PUT-Motorsport/PUTM_EV_IMD_SAFETY_2024/README.md

# Insulation Monitoring Device driver

A driver for Bender ISOMETER IR155-3203 to comply with FSG Rules 25' about latching, and only hard-wired electronics.
As per September 2025 in PMX Malta it relies only on Bender "IMD OK" signal, no PWM reading part needed
