PUT-Motorsport/PUTM_EV_IMD_SAFETY_2024/documentation/Bender_Dimensions.png

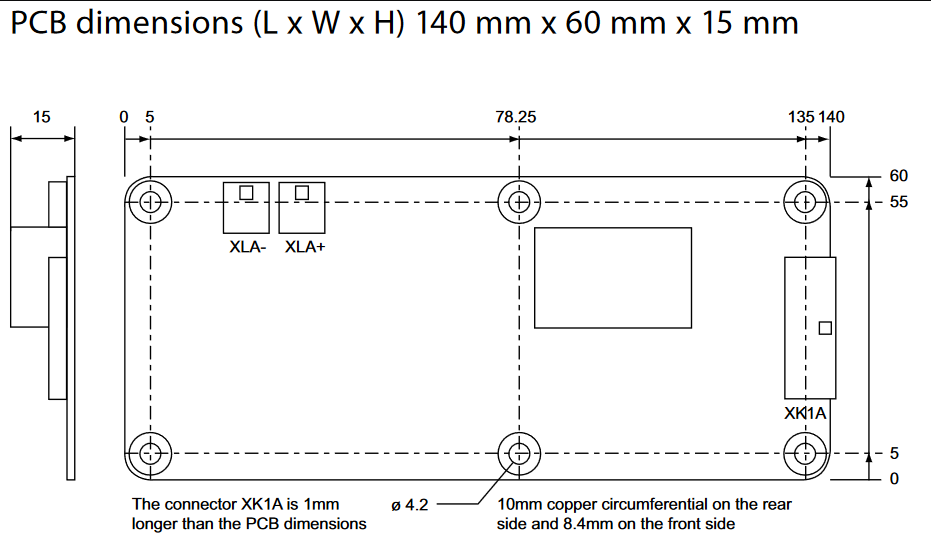
documentation/Bender_Dimensions.png
