PUT-Motorsport/PUTM_EV_IMD_SAFETY_2024/documentation/ESF22_review.png

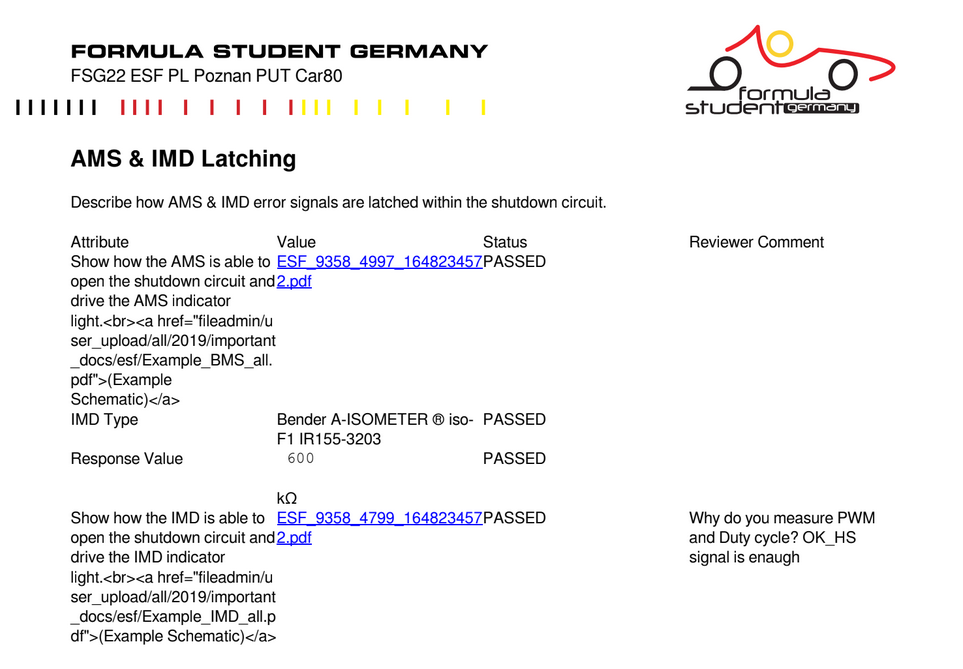
documentation/ESF22_review.png
