PUT-Motorsport/PUTM_EV_IMD_SAFETY_2024/documentation/ESF_Dash_LED_Example.png

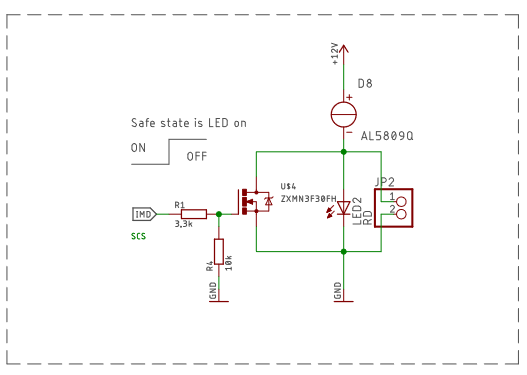
documentation/ESF_Dash_LED_Example.png
