PUT-Motorsport/PUTM_EV_IMD_SAFETY_2024/documentation/ESF_Example_Autoreset.png

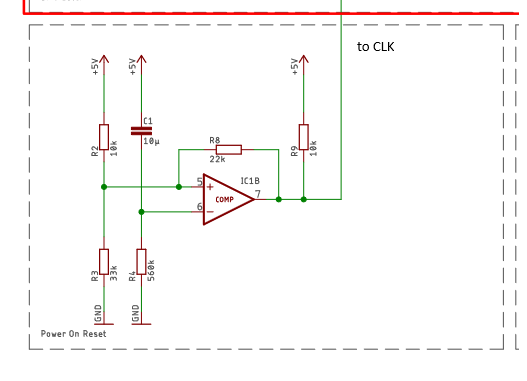
documentation/ESF_Example_Autoreset.png
