PUT-Motorsport/PUTM_EV_IMD_SAFETY_2024/documentation/ESF_Latch_Example.png

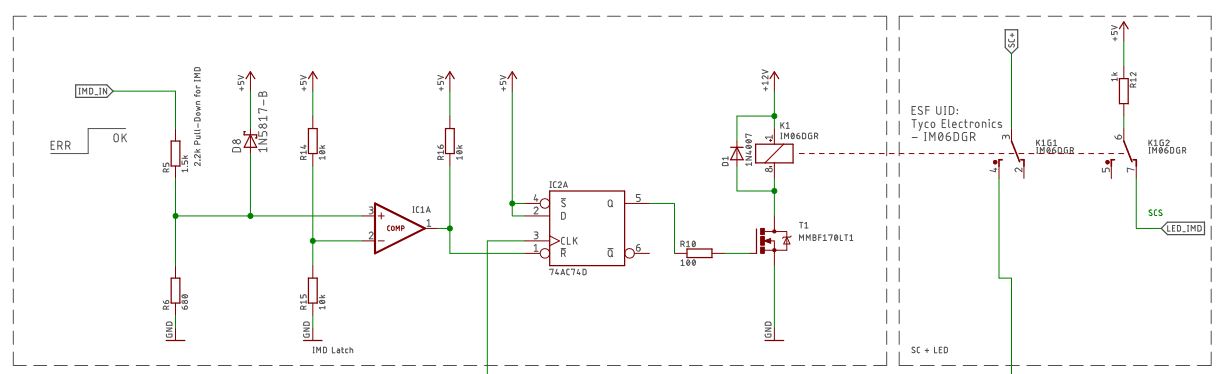
documentation/ESF_Latch_Example.png
