PUT-Motorsport/PUTM_EV_IMD_SAFETY_2024/documentation/ESF_Doc_SDC-IMD_Latch.pdf

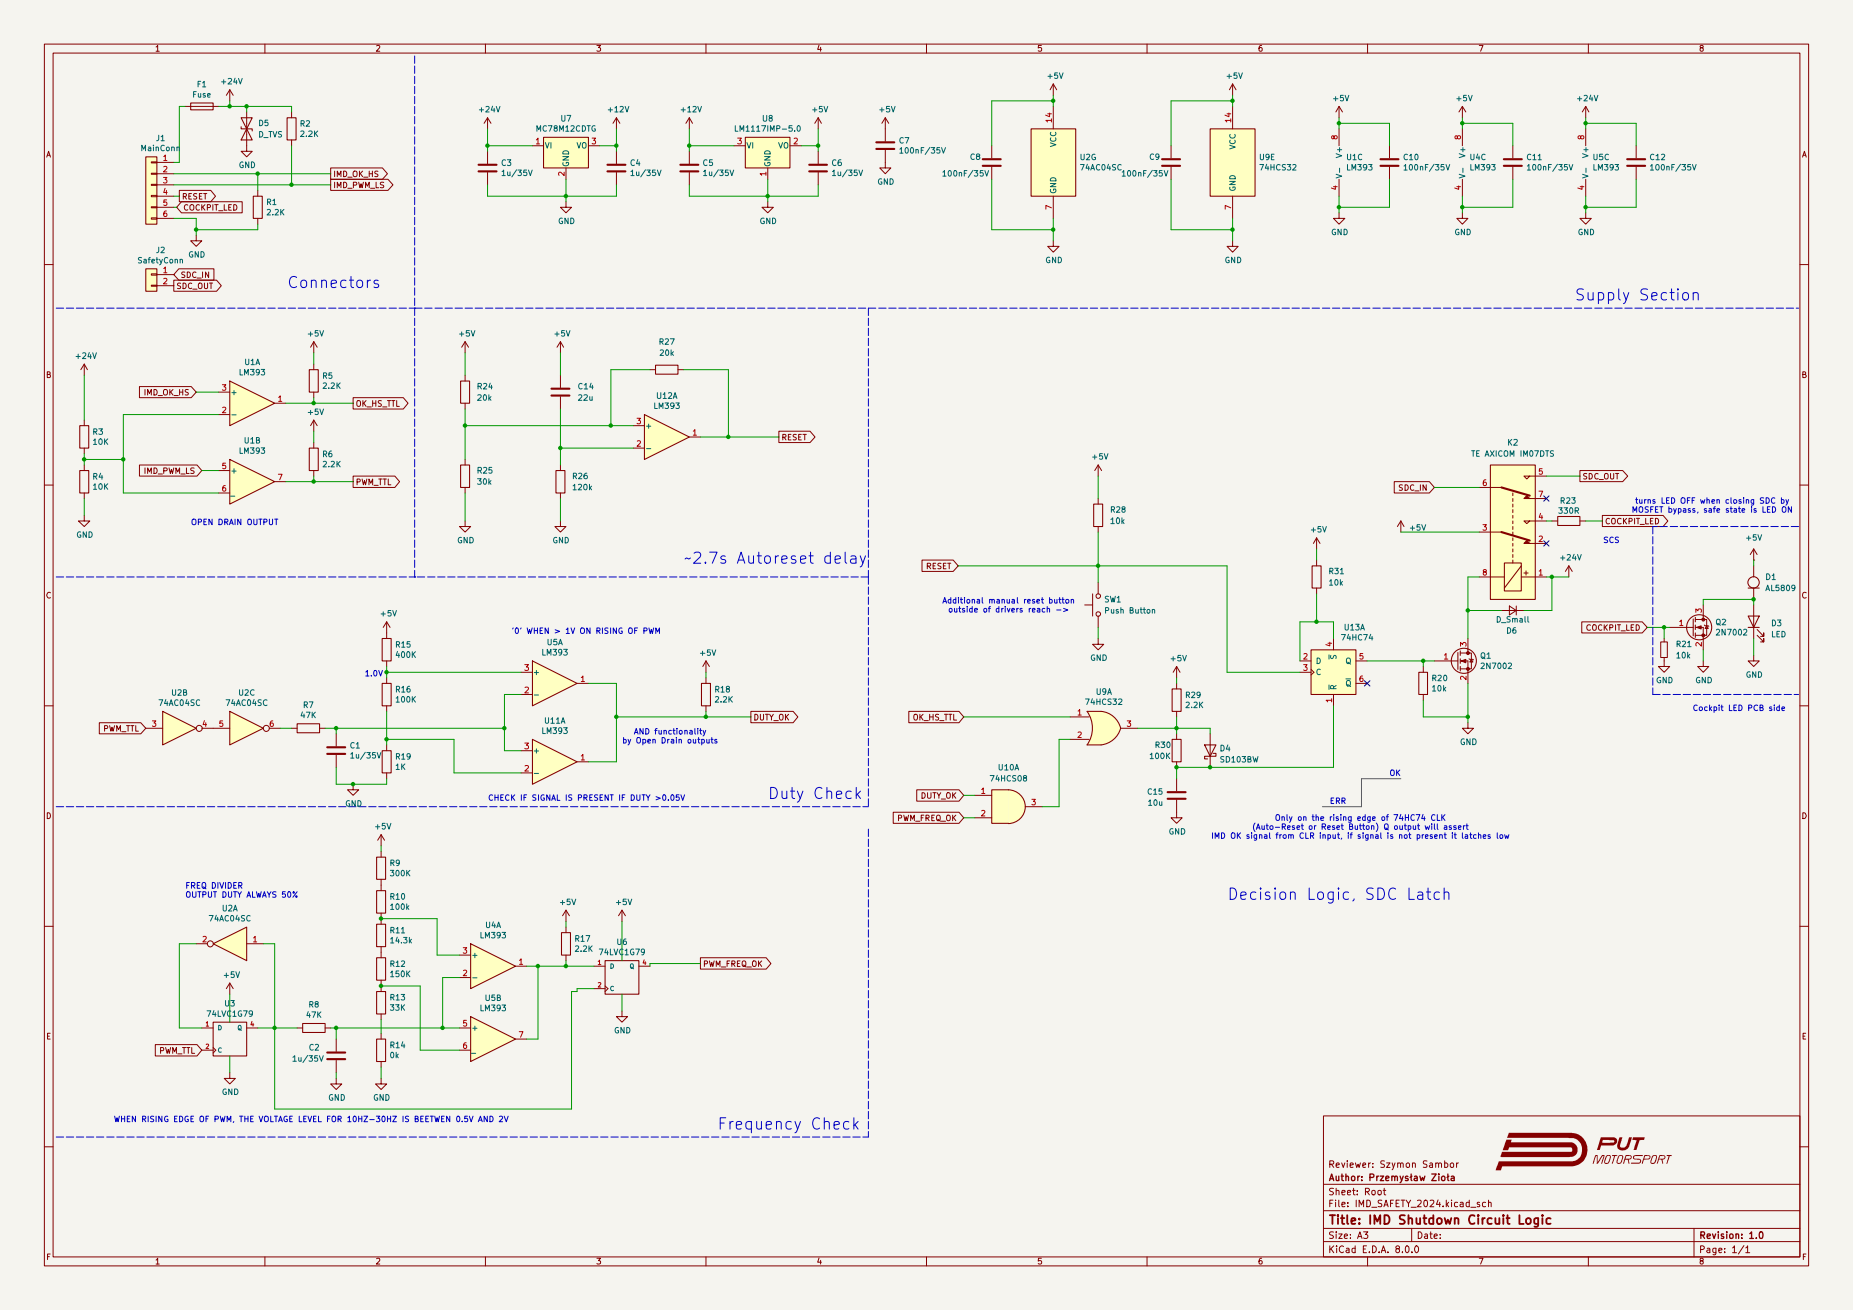
[picture p6: page 1]
