PUT-Motorsport/PUTM_EV_IMD_SAFETY_2024/documentation/new_autoreset_2.asc

C1: polcap; 22µ; V=16 Irms=30m Rser=1.6383 Lser=1.778n mfg="Würth Elektronik" pn="865230342002 WCAP-AS5H 5x5,5" type="Al electrolytic"
D1: schottky; RB557W
R1: res; 30k
R2: res; 20k
R3: res; 120k
R4: res; 20k
R7: res; 10k
R8: res; 10k
R9: res; 10k
S1: sw; BTN
U2: lm393
U3: 74hc74
V1: voltage; PULSE(0 5 1p 1p 1p 3s)
V2: voltage; PULSE(0 2 2.5 10m 10m 200m)
V3: voltage; PULSE(0 5 1 10m 200m 1.8)
Named nets: 0, +5V, tau1, COMP1|BTN, Q, IMD_OK
.tran 3s
active low
manual button press
.model BTN SW(Ron=1 Roff=2.2Meg Vt=1 Vh=0.02)
IMD OK signal source
---> Only on the rising edge of CLK
(Auto-Reset or Reset Button) Q output will assert
IMD OK signal, if signal is not present it latches low
autoreset feature
