PUT-Motorsport/PUTM_EV_IMD_SAFETY_2024/hardware/IMD_SAFETY_2024.kicad_pcb

## KiCad design hardware/IMD_SAFETY_2024.kicad_pcb (2025-03-15)

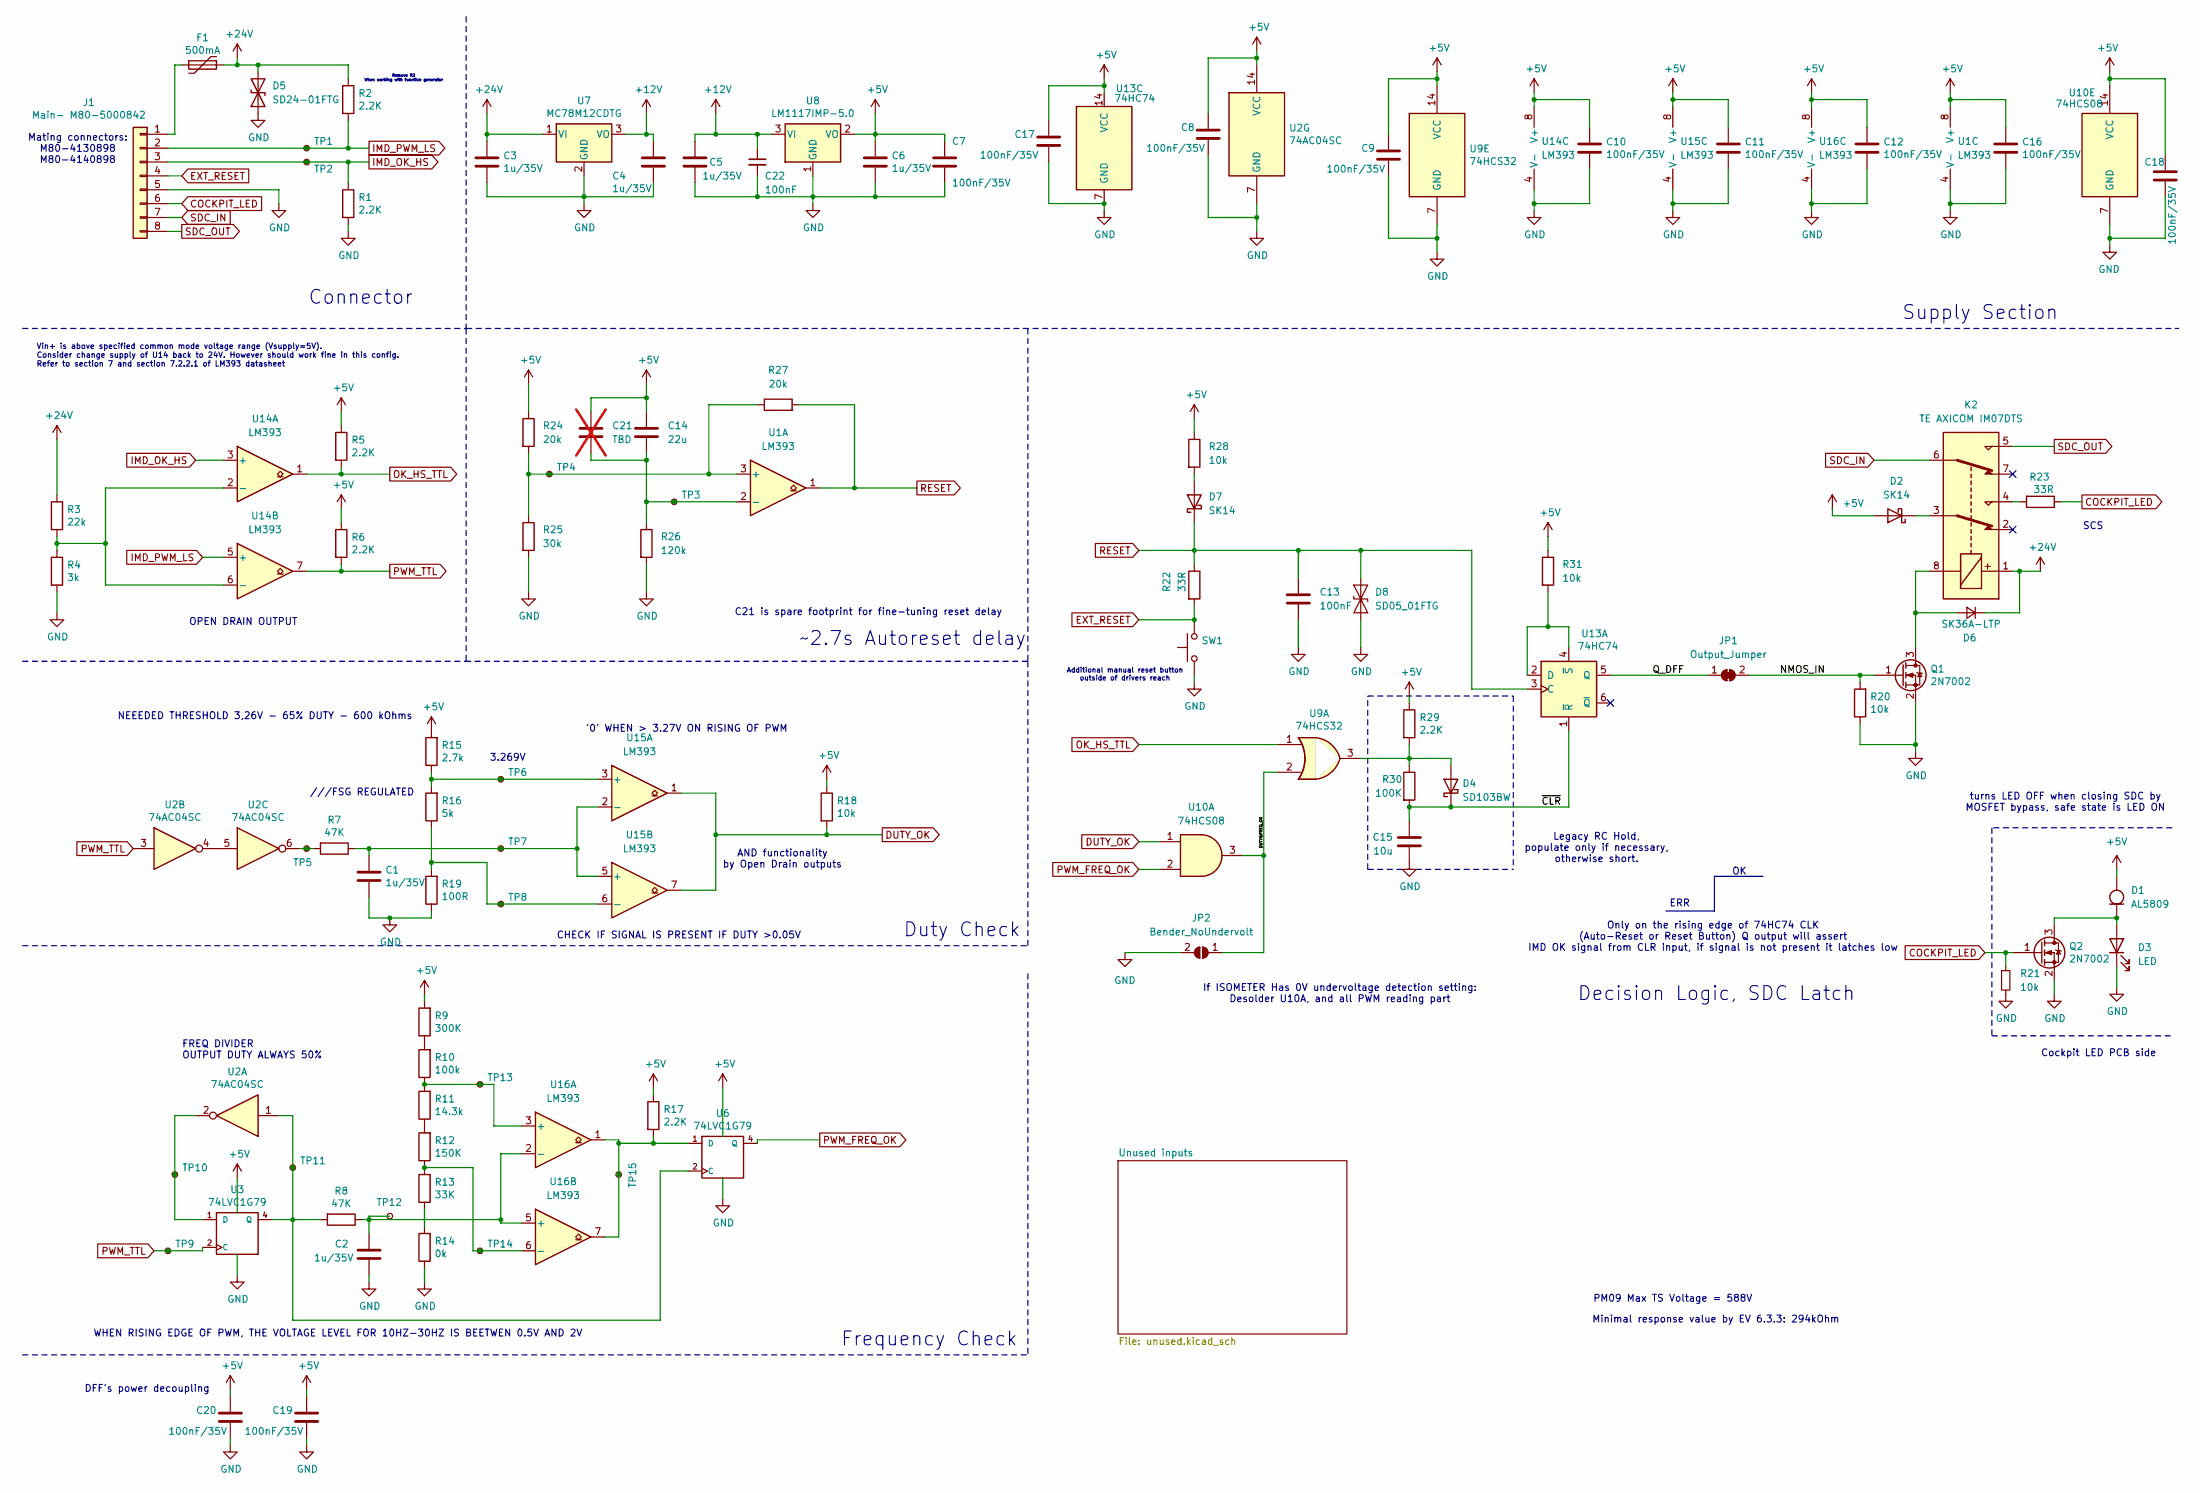
[picture p7: schematic IMD_SAFETY_2024.kicad_sch, IMD Shutdown Circuit Logic]

Parts:
C1, C2, C3, C4, C5, C6: 1u/35V; C_0805_2012Metric
C7, C8, C9, C10, C11, C12, C16, C17, C18, C19, C20: 100nF/35V; C_0603_1608Metric
C13: 100nF; C_0603_1608Metric_Pad1.08x0.95mm_HandSolder
C14: 22u; C_1206_3216Metric; Mouser# 187-CL31A226KOHNNWE
C15: 10u; C_1206_3216Metric; Mouser# 187-CL31A106MQHNNNE
C21: TBD; C_1206_3216Metric; not fitted
C22: 100nF; C_0603_1608Metric
D1: AL5809
D2, D7: SK14; D_SMA; Mouser# 637-SK14
D3: LED
D4: SD103BW; D_SOD-123F; Mouser# 637-SD103BW
D5: SD24-01FTG; SOD2613X114N
D6: SK36A-LTP; DIOM5226X244N; Mouser# 833-SK36A-LTP
D8: SD05_01FTG; D_SOD-323
F1: 500mA; Fuse_1206_3216Metric; Mouser# 576-1206L050/24WR
J1: Main- M80-5000842; M80-50008YY_2
JP1: Output_Jumper; SolderJumper-2_P1.3mm_Open_Pad1.0x1.5mm
JP2: Bender_NoUndervolt; SolderJumper-2_P1.3mm_Open_Pad1.0x1.5mm
K2: TE AXICOM IM07DTS; IM23TS
Q1: 2N7002; SOT-23; Mouser# 726-2N7002H6327XTSA2
Q2: 2N7002; SOT-23
R1, R2, R5, R6, R17, R29: 2.2K; R_0603_1608Metric
R3: 22k; R_0603_1608Metric
R4: 3k; R_0603_1608Metric
R7, R8: 47K; R_0603_1608Metric
R9: 300K; R_0603_1608Metric
R10: 100k; R_0603_1608Metric
R11: 14.3k; R_0603_1608Metric
R12: 150K; R_0603_1608Metric
R13: 33K; R_0603_1608Metric
R14: 0k; R_0603_1608Metric
R15: 2.7k; R_0603_1608Metric
R16: 5k; R_0603_1608Metric
R18, R20, R28, R31: 10k; R_0603_1608Metric
R19: 100R; R_0603_1608Metric
R21: 10k
R22, R23: 33R; R_0805_2012Metric
R24, R27: 20k; R_0603_1608Metric
R25: 30k; R_0603_1608Metric
R26: 120k; R_0603_1608Metric
R30: 100K; R_0603_1608Metric
SW1: Push Button
TP1, TP2, TP3, TP4, TP5, TP6, TP7, TP8, TP9, TP10, TP11, TP12, TP13, TP14, TP15: TestPoint_Small; TestPoint_Pad_D1.0mm
U1, U14, U15, U16: LM393; SOIC127P600X175-8N; Mouser# 595-LM393ADR
U2: 74AC04SC; SOIC-14_3.9x8.7mm_P1.27mm; Mouser# 512-74AC04SC
U3, U6: 74LVC1G79; SOT-23-5; Mouser# 595-SN74LVC1G79DBVR
U7: MC78M12CDTG; TO-252-3_TabPin2; Mouser# 863-MC7812ACD2TR4G
U8: LM1117IMP-5.0; SOT-223-3_TabPin2; Mouser# 926-LM1117IMPX50NOPB
U9: 74HCS32; SOP65P640X120-14N; Mouser# 595-SN74HCS32PWR
U10: 74HCS08; SOP65P640X120-14N; Mouser# 595-SN74HCS08PWR
U13: 74HC74; SOP65P640X120-14N

Connections:
+5V: C6.1, C7.1, C8.1, C9.1, C10.1, C11.1, C12.1, C14.1, C16.1, C17.1, C18.1, C19.1, C20.1, C21.1, D1.2 (A), D2.2 (A), R5.1, R6.1, R9.2, R15.2, R17.1, R18.1, R24.1, R28.1, R29.1, R31.1, U1.8 (V+), U2.14 (VCC), U3.5 (VCC), U6.5 (VCC), U8.2 (VO), U9.14 (VCC), U10.14 (VCC), U13.14 (VCC), U14.8 (V+), U15.8 (V+), U16.8 (V+); also elsewhere on the board
+12V: C4.1, C5.1, C22.1, U7.3 (VO), U8.3 (VI)
+24V: C3.1, D5.2 (A2), D6.1 (K), F1.1, K2.1, R2.1, R3.1, U7.1 (VI)
/DUTY&FREQ_OK: JP2.1 (A), U9.2, U10.3
/NMOS_IN: JP1.2 (B), Q1.1 (G), R20.2
/Q_DFF: JP1.1 (A), U13.5 (Q)
/~CLR: C15.1, D4.1 (K), R30.2, U13.1 (~R)
COCKPIT_LED: J1.6, Q2.1 (G), R21.1, R23.1
DUTY_OK: R18.2, U10.1, U15.1, U15.7
EXT_RESET: J1.4, R22.2, SW1.2
GND: C1.2, C2.2, C3.2, C4.2, C5.2, C6.2, C7.2, C8.2, C9.2, C10.2, C11.2, C12.2, C13.2, C15.2, C16.2, C17.2, C18.2, C19.2, C20.2, C22.2, D3.1 (K), D5.1 (A1), D8.2 (A2), J1.5, JP2.2 (B), Q1.2 (S), Q2.2 (S), R1.2, R4.2, R14.1, R19.1, R20.1, R21.2, R25.2, R26.2, SW1.1, U1.4 (V-), U2.7 (GND), U3.3 (GND), U6.3 (GND), U7.2 (GND), U8.1 (GND), U9.7 (GND), U10.7 (GND), U13.7 (GND), U14.4 (V-), U15.4 (V-), U16.4 (V-); also elsewhere on the board
IMD_OK_HS: J1.3, R1.1, TP2.1, U14.3 (+)
IMD_PWM_LS: J1.2, R2.2, TP1.1, U14.5 (+)
unnamed: D1.1 (K), D3.2 (A), Q2.3 (D)
unnamed: D2.1 (K), K2.3
unnamed: D4.2 (A), R29.2, R30.1, U9.3
unnamed: D6.2 (A), K2.8, Q1.3 (D)
unnamed: D7.2 (A), R28.2
unnamed: F1.2, J1.1
unnamed: K2.4, R23.2
unnamed: R7.2, TP5.1, U2.6
unnamed: R9.1, R10.2
unnamed: R11.1, R12.2
unnamed: R13.1, R14.2
unnamed: R24.2, R25.1, R27.1, TP4.1, U1.3 (+)
unnamed: C14.2, C21.2, R26.1, TP3.1, U1.2 (-)
unnamed: U2.4, U2.5
unnamed: TP10.1, U2.2, U3.1 (D)
unnamed: R8.2, TP11.1, U2.1, U3.4 (Q), U6.2 (C)
unnamed: R17.2, TP15.1, U6.1 (D), U16.1, U16.7
unnamed: R31.2, U13.2 (D), U13.4 (~S)
unnamed: R3.2, R4.1, U14.2 (-), U14.6 (-)
unnamed: R15.1, R16.2, TP6.1, U15.3 (+)
unnamed: C1.1, R7.1, TP7.1, U15.2 (-), U15.5 (+)
unnamed: R16.1, R19.2, TP8.1, U15.6 (-)
unnamed: R10.1, R11.2, TP13.1, U16.3 (+)
unnamed: C2.1, R8.1, TP12.1, U16.2 (-), U16.5 (+)
unnamed: R12.1, R13.2, TP14.1, U16.6 (-)
OK_HS_TTL: R5.2, U9.1, U14.1
PWM_FREQ_OK: U6.4 (Q), U10.2
PWM_TTL: R6.2, TP9.1, U2.3, U3.2 (C), U14.7
RESET: C13.1, D7.1 (K), D8.1 (A1), R22.1, R27.2, U1.1, U13.3 (C)
SDC_IN: J1.7, K2.6
SDC_OUT: J1.8, K2.5

Notes on the sheet:
Minimal response value by EV 6.3.3: 294kOhm
C21 is spare footprint for fine-tuning reset delay
FREQ DIVIDER OUTPUT DUTY ALWAYS 50%
///FSG REGULATED
Decision Logic, SDC Latch
WHEN RISING EDGE OF PWM, THE VOLTAGE LEVEL FOR 10HZ-30HZ IS BEETWEN 0.5V AND 2V
~2.7s Autoreset delay
Legacy RC Hold, populate only if necessary, otherwise short.
DFF's power decoupling
ERR
CHECK IF SIGNAL IS PRESENT IF DUTY >0.05V
Remove R2 When working with function generator
Cockpit LED PCB side
3.269V
PM09 Max TS Voltage = 588V
Mating connectors: M80-4130898 M80-4140898
'0' WHEN > 3.27V ON RISING OF PWM
Additional manual reset button outside of drivers reach
If ISOMETER Has 0V undervoltage detection setting: Desolder U10A, and all PWM reading part
AND functionality by Open Drain outputs
OPEN DRAIN OUTPUT
Frequency Check
Supply Section
Duty Check
turns LED OFF when closing SDC by MOSFET bypass, safe state is LED ON
NEEEDED THRESHOLD 3,26V - 65% DUTY - 600 kOhms
SCS
Connector
Vin+ is above specified common mode voltage range (Vsupply=5V). Consider change supply of U14 back to 24V. However should work fine in this config. Refer to section 7 and section 7.2.2.1 of LM393 datasheet
Only on the rising edge of 74HC74 CLK (Auto-Reset or Reset Button) Q output will assert IMD OK signal from CLR input, if signal is not present it latches low

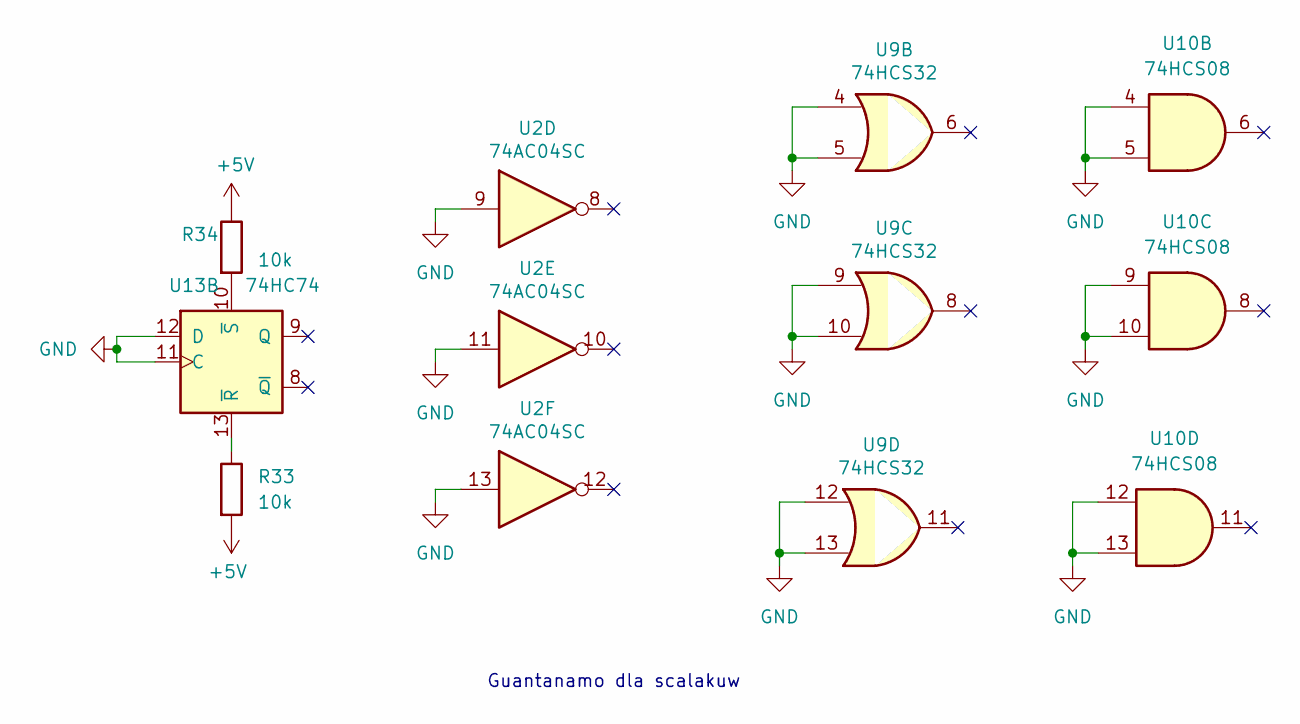
[picture p8: schematic unused.kicad_sch]

Parts:
R33, R34: 10k; R_0603_1608Metric
U2: 74AC04SC; SOIC-14_3.9x8.7mm_P1.27mm; Mouser# 512-74AC04SC
U9: 74HCS32; SOP65P640X120-14N; Mouser# 595-SN74HCS32PWR
U10: 74HCS08; SOP65P640X120-14N; Mouser# 595-SN74HCS08PWR
U13: 74HC74; SOP65P640X120-14N

Connections:
+5V: R33.2, R34.1; also elsewhere on the board
GND: U2.9, U2.11, U2.13, U9.4, U9.5, U9.9, U9.10, U9.12, U9.13, U10.4, U10.5, U10.9, U10.10, U10.12, U10.13, U13.11 (C), U13.12 (D); also elsewhere on the board
unnamed: R33.1, U13.13 (~R)
unnamed: R34.2, U13.10 (~S)

Notes on the sheet:
Guantanamo dla scalakuw

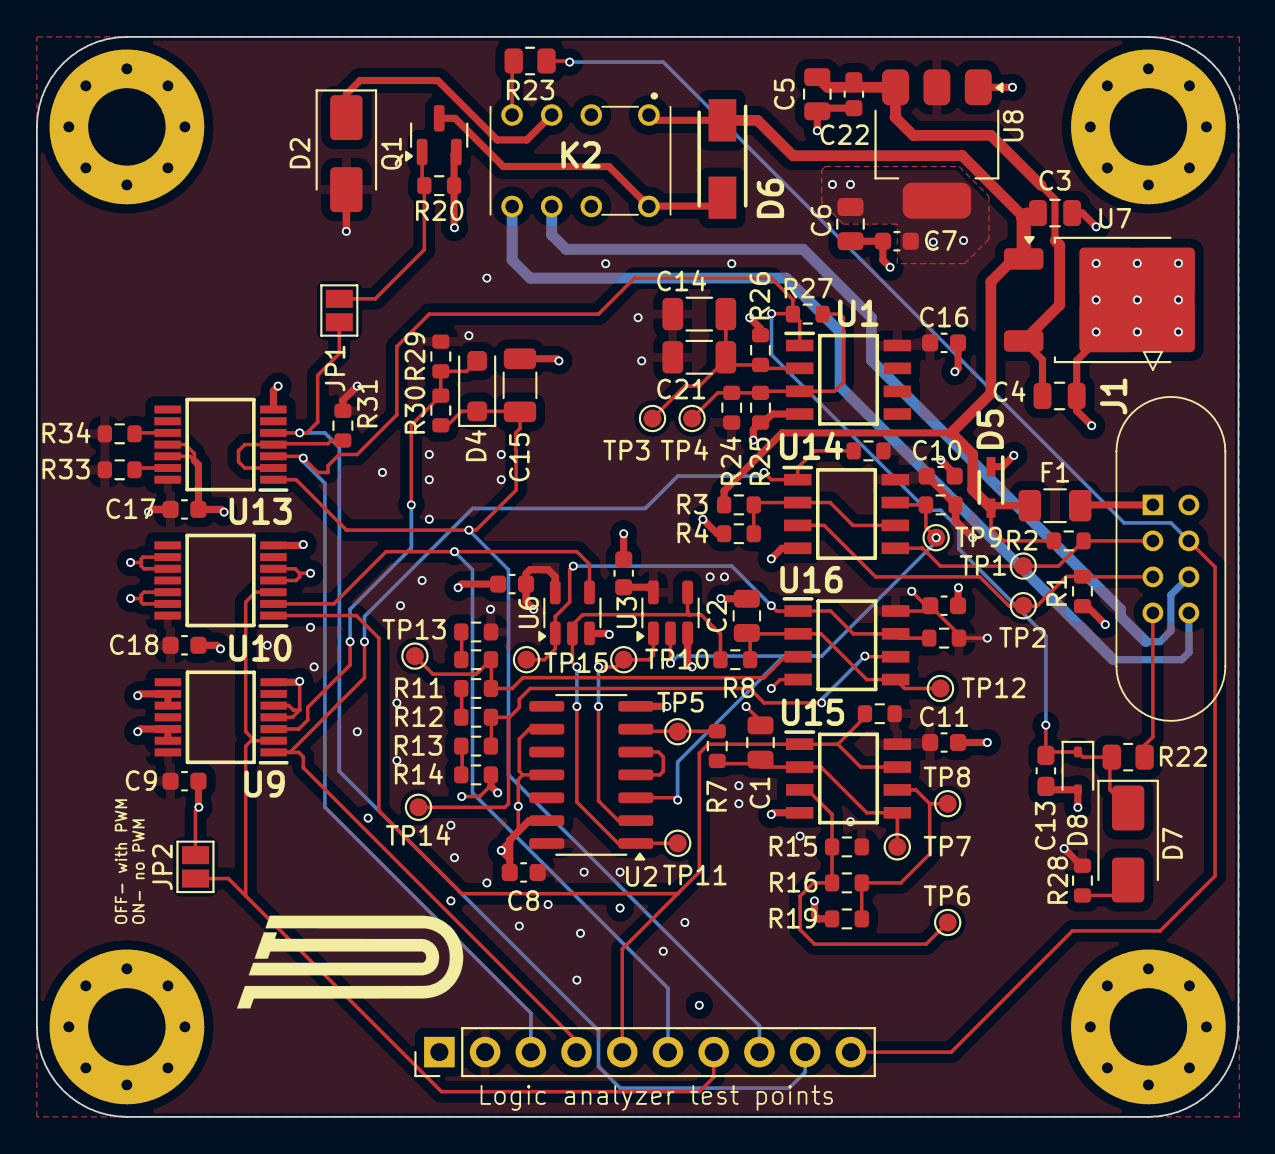
[picture p9: board IMD_SAFETY_2024.kicad_pcb from above]

Board: 4 copper layers, 66.8 x 60.0 mm, 93 parts (0 on the bottom side), 45 nets.
