PUT-Motorsport/PUTM_EV_IMD_SAFETY_2024/(commit log)

2024-03-11 add new autoreset simulation draft
    [IMD_SAFETY_2024.kicad_pcb, IMD_SAFETY_2024.kicad_sch]
2024-04-09 ESF schematic version, relay switched to AXICOM
    [IMD_SAFETY_2024.kicad_sch, PUTM_EV_IMD_SAFETY_2024.kicad_pcb, PUTM_EV_IMD_SAFETY_2024.kicad_sch]
2024-04-09 Remove redundant files
    [PUTM_EV_IMD_SAFETY_2024.kicad_pcb, PUTM_EV_IMD_SAFETY_2024.kicad_sch]
2024-04-12 IC footprints assign
    [IMD_SAFETY_2024.kicad_pcb, IMD_SAFETY_2024.kicad_sch]
2024-04-16 Passives footprint assignment
    [IMD_SAFETY_2024.kicad_pcb, IMD_SAFETY_2024.kicad_sch]
2024-04-24 WIP Layout
    [IMD_SAFETY_2024.kicad_pcb, IMD_SAFETY_2024.kicad_sch, unused.kicad_sch]
2024-04-25 WIP Routing
    [IMD_SAFETY_2024.kicad_pcb]
2024-04-28 0xDRC, ready for review
    [IMD_SAFETY_2024.kicad_pcb]
2024-04-29 Production Files
    [IMD_SAFETY_2024.kicad_pcb]
2024-06-08 Updated R3 R4 Values
    [IMD_SAFETY_2024.kicad_sch]
2024-08-16 FSG fuckup comment
    [IMD_SAFETY_2024.kicad_sch]
2024-10-12 Add reset line transient surpression
    [IMD_SAFETY_2024.kicad_sch]
2024-10-14 OxDRC state, 2.1.0 ready to review, change connector to vertical, and R-Reset node slightly
    [IMD_SAFETY_2024.kicad_pcb, IMD_SAFETY_2024.kicad_sch]
2024-10-15 2.1.0 Release, adjust after review
    [IMD_SAFETY_2024.kicad_pcb, IMD_SAFETY_2024.kicad_sch]
2024-11-26 Add 0V jumper
    [IMD_SAFETY_2024.kicad_pcb, IMD_SAFETY_2024.kicad_sch]
2025-03-15 Add input stage LM393 comment
    [IMD_SAFETY_2024.csv, IMD_SAFETY_2024.kicad_pcb, IMD_SAFETY_2024.kicad_sch, unused.kicad_sch]
